psegovia2022/nervetoolsV2/images/BrainDishProject2Sm.jpg

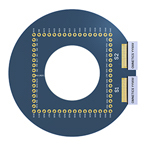
images/BrainDishProject2Sm.jpg
