psegovia2022/nervetoolsV2/images/EIB64Sm.jpg

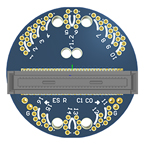
images/EIB64Sm.jpg
