psegovia2022/nervetoolsV2/images/bigManip_big.png

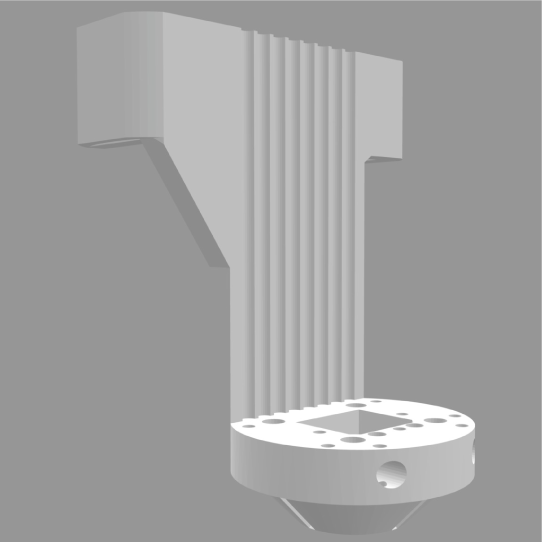
images/bigManip_big.png
