psegovia2022/nervetoolsV2/images/bigManip_small.png

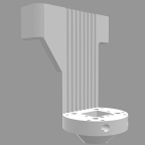
images/bigManip_small.png
