psegovia2022/nervetoolsV2/images/BrainDishProjectSm.jpg

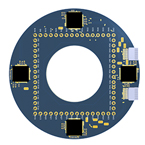
images/BrainDishProjectSm.jpg
