psegovia2022/nervetoolsV2/images/cylinder1.jpg

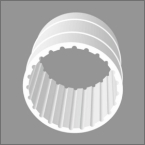
images/cylinder1.jpg
