psegovia2022/nervetoolsV2/images/EIB16Sm.jpg

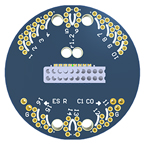
images/EIB16Sm.jpg
