psegovia2022/nervetoolsV2/images/EIB32Sm.png

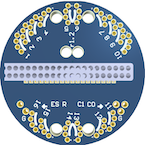
images/EIB32Sm.png
