psegovia2022/nervetoolsV2/images/electrodeHolderLongSym.jpg

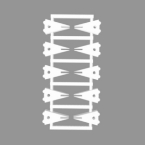
images/electrodeHolderLongSym.jpg
