psegovia2022/nervetoolsV2/images/flexElectrodes_small.png

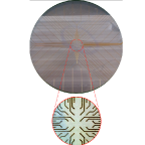
images/flexElectrodes_small.png
