psegovia2022/nervetoolsV2/images/insertSmall.png

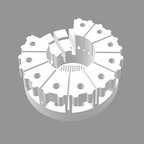
images/insertSmall.png
