psegovia2022/nervetoolsV2/images/intanGuiSm.jpg

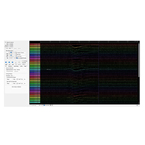
images/intanGuiSm.jpg
