psegovia2022/nervetoolsV2/images/lid1.jpg

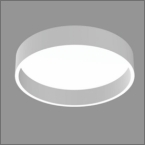
images/lid1.jpg
