psegovia2022/nervetoolsV2/images/marcelo2.jpeg

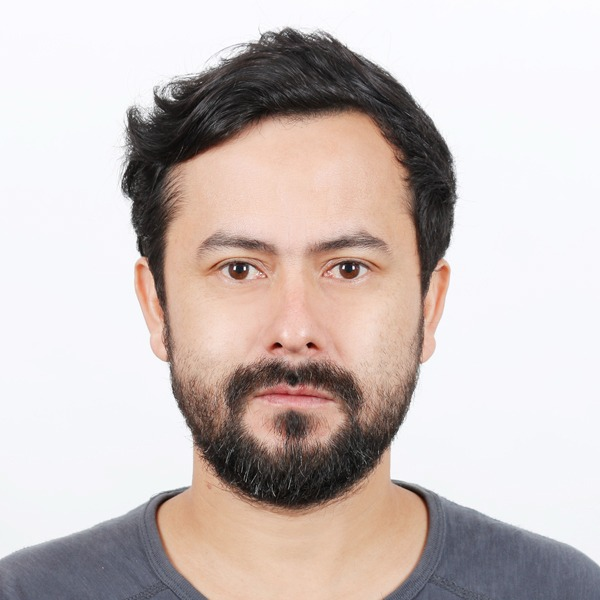
images/marcelo2.jpeg
