psegovia2022/nervetoolsV2/images/pcb32chs_Small.png

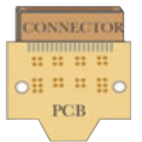
images/pcb32chs_Small.png
