psegovia2022/nervetoolsV2/images/screw0090Sm.jpg

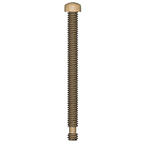
images/screw0090Sm.jpg
