psegovia2022/nervetoolsV2/images/screwLocks.jpg

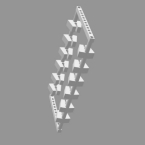
images/screwLocks.jpg
