psegovia2022/nervetoolsV2/images/tinyHeadstageMd.jpg

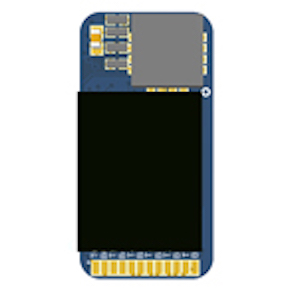
images/tinyHeadstageMd.jpg
