psegovia2022/nervetoolsV2/images/symetricLongHolders.stl

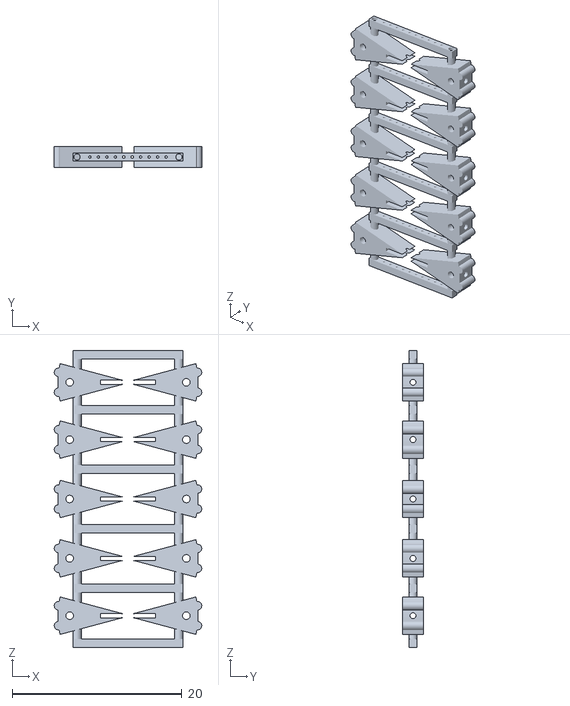
[picture p24: CAD file, 2023-04-05]
images/symetricLongHolders.stl
17.4 x 2.50 x 35.0
