psegovia2022/nervetoolsV2/images/insertSmall.stl

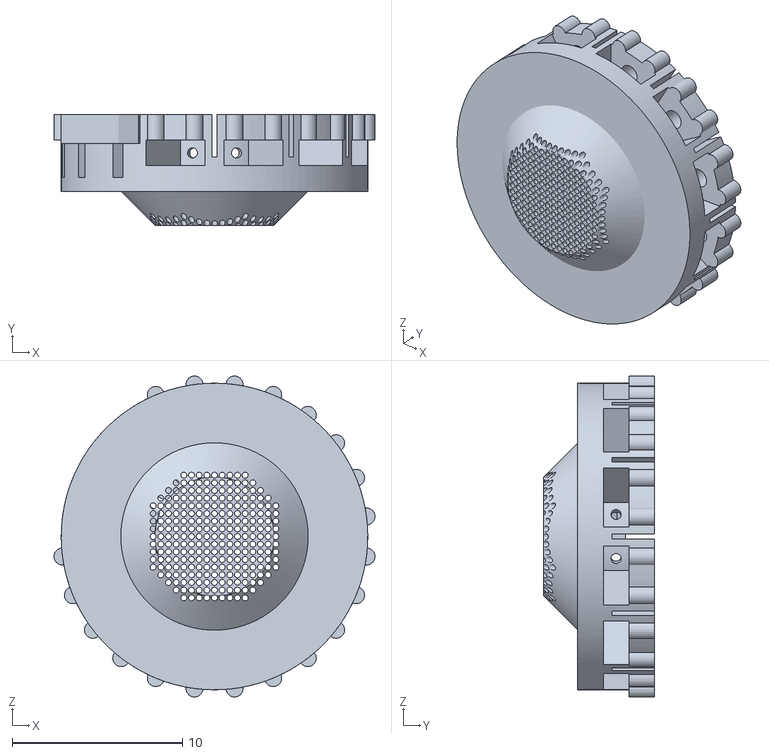
[picture p25: CAD file, 2023-04-05]
images/insertSmall.stl
18.8 x 6.50 x 18.8
