psegovia2022/nervetoolsV2/images/shortHolders.stl

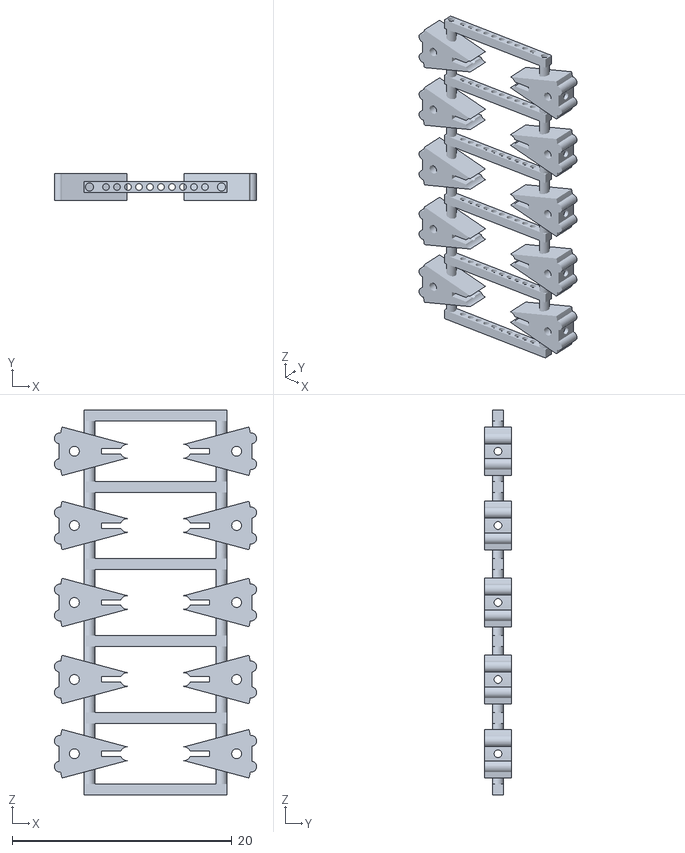
[picture p26: CAD file, 2023-04-05]
images/shortHolders.stl
18.4 x 2.50 x 35.0
