psegovia2022/nervetoolsV2/images/cupSmall.stl

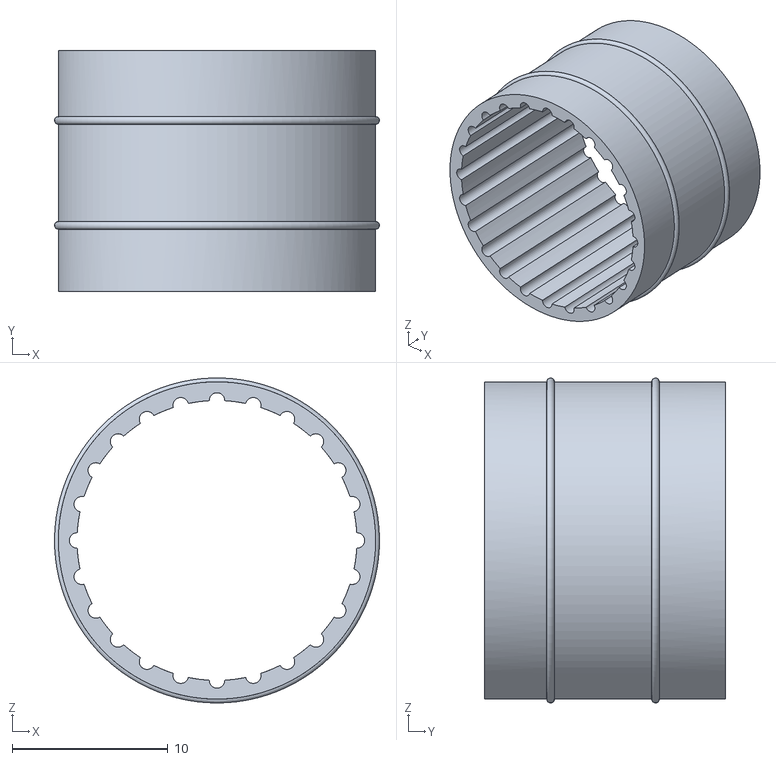
[picture p27: CAD file, 2023-04-05]
images/cupSmall.stl
20.9 x 15.5 x 20.9
