psegovia2022/nervetoolsV2/images/lidSmall.stl

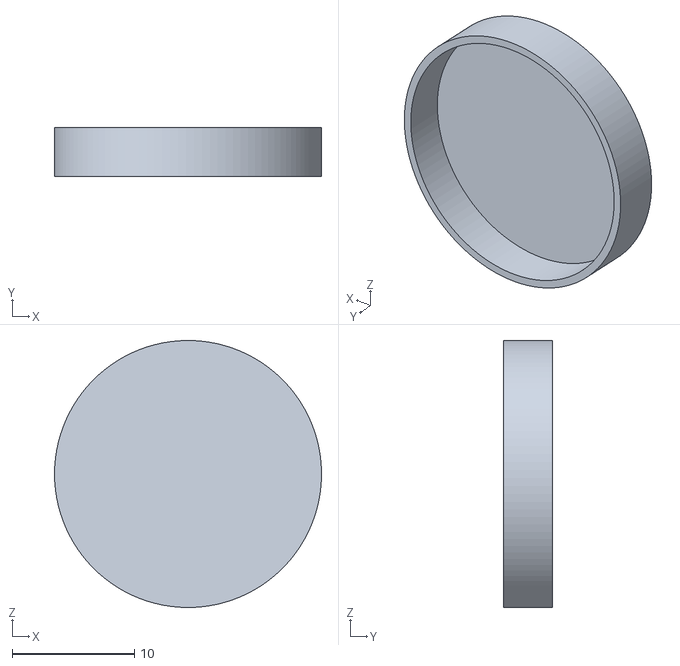
[picture p28: CAD file, 2023-04-05]
images/lidSmall.stl
21.8 x 4.00 x 21.8
