psegovia2022/nervetoolsV2/images/screwLocks.stl

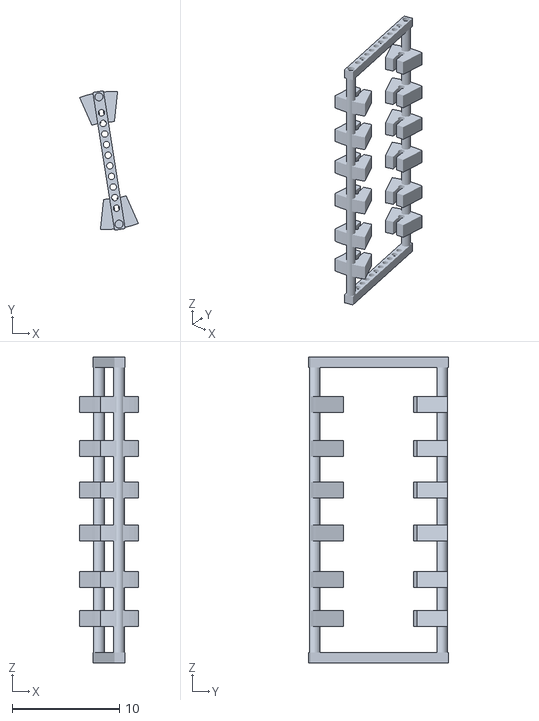
[picture p29: CAD file, 2023-04-05]
images/screwLocks.stl
5.48 x 13.0 x 28.5
